Campus-Shuttle-Monitor/cs4096/(commit log)

2021-02-19 only send coordinates when position fix has been found
    [LORA_CLIENT_Tx.ino]
2021-02-22 Print statements and transmission when position is not fixed
    [LORA_CLIENT_Tx.ino]
2021-02-22 implemented watchdog timer - Uno resets if program hangs
    [LORA_CLIENT_Tx.ino]
2021-02-22 Fixed validating NMEA sentence bug
    [LORA_CLIENT_Tx.ino]
2021-02-22 Fixed NMEA sentence validation bug
    [LORA_CLIENT_Tx.ino]
2021-02-28 deleted print statements
2021-03-26 added print statements for HTTPS request status
2021-04-23 got rid of logging and sensitive print statements
